Tinkerforge/tng-di8/hardware/di8.kicad_pcb

## KiCad design hardware/di8.kicad_pcb (2020-09-10)

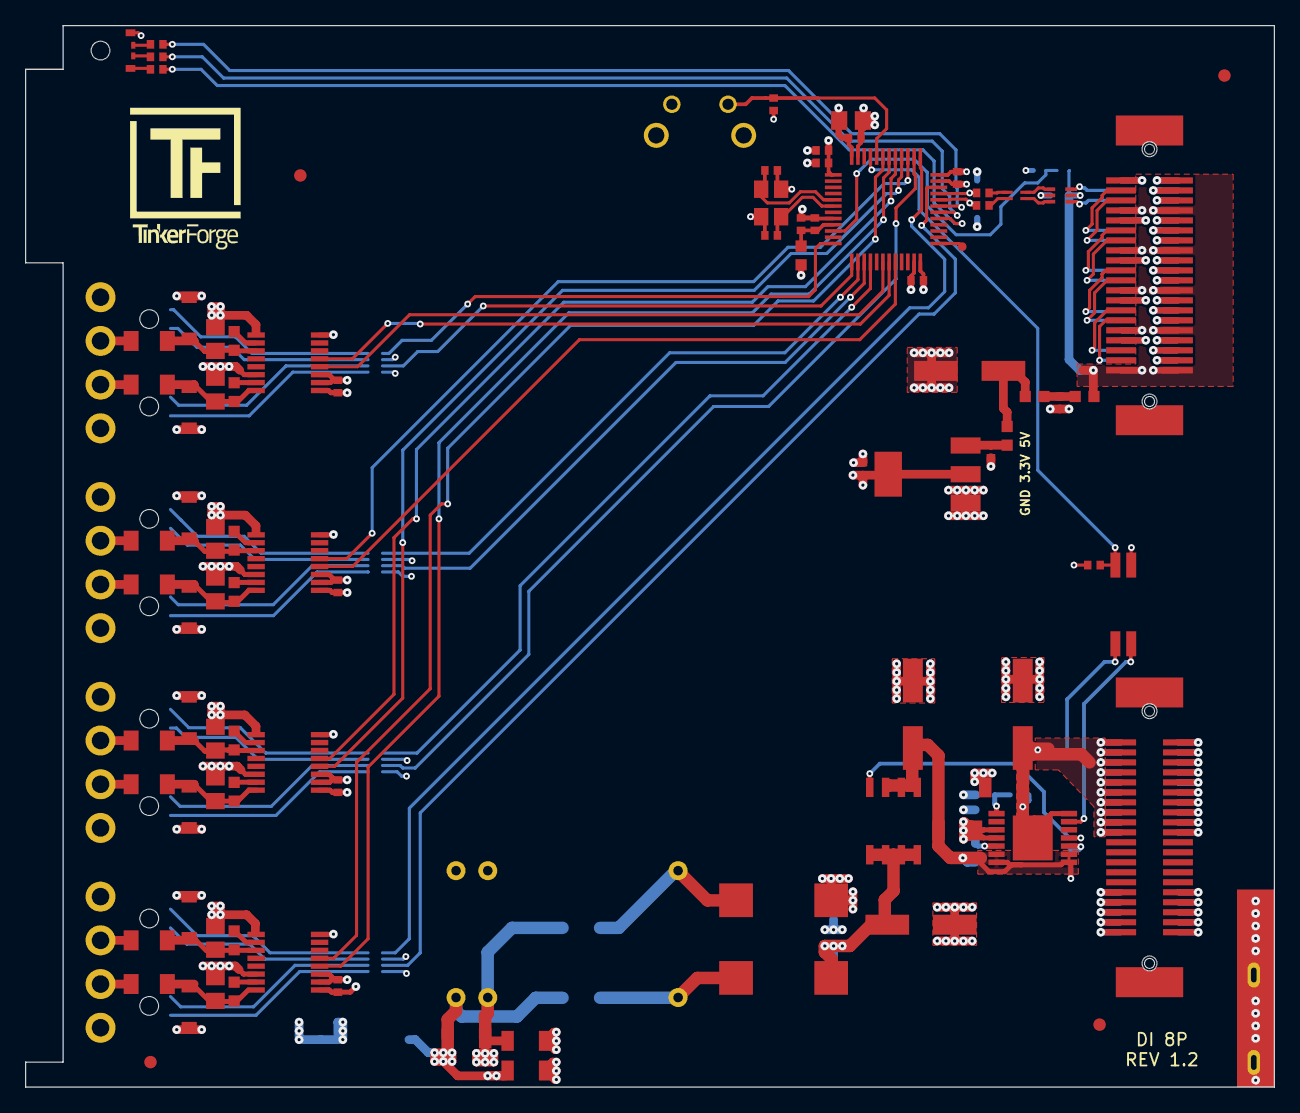
[picture p1: board di8.kicad_pcb from above]

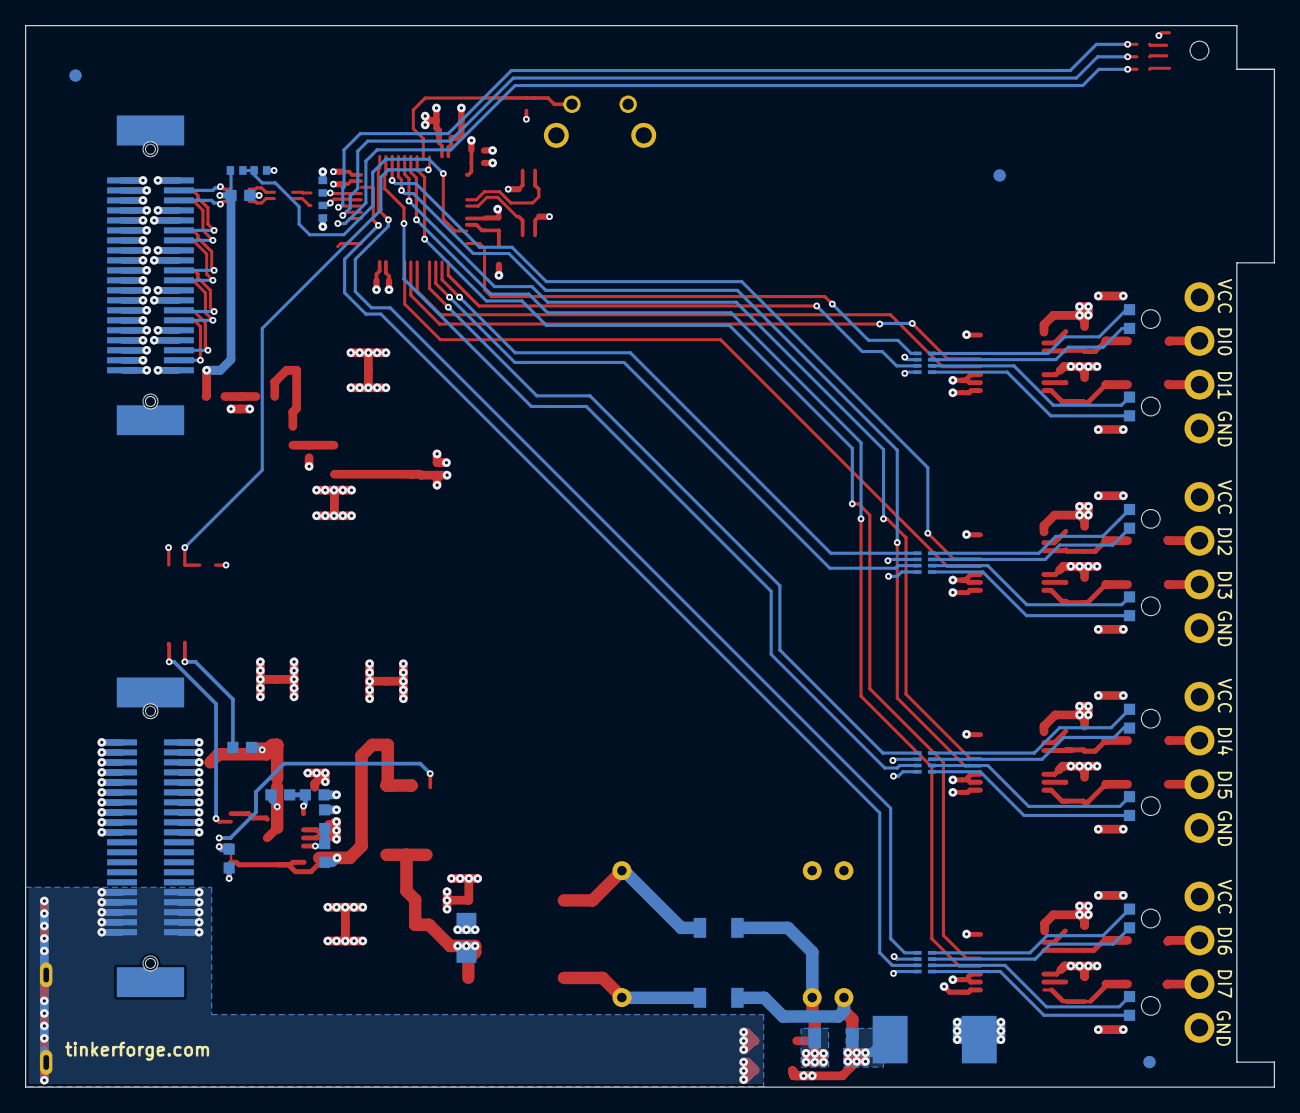
[picture p2: board di8.kicad_pcb from below]

Board: 4 copper layers, 100.0 x 85.0 mm, 130 parts (33 on the bottom side), 106 nets.

Parts:
C101, C102, C116, C117: 1uF; C0402F
C103, C104, C105, C106, C107, C112, C204, C211, C212, C213: 100nF; C0402F
C108, C109: 33pF; C0402F
C110: 10uF; C0805E
C111: 100uF; ELKO_63
C113, C114: 47pF; C0402F
C115: 2.2uF; C0603F
C118: 10uF/50V; C1206
C119, C120: 0; C1206
C121, C125, C126: 10uF/35V; C1206
C122, C123, C124: 100uF/35V; ELKO_63
C127, C128: 1nF/2kV; C1206
C202, C203, C205, C206, C207, C208, C209, C210: DNP; C0805E
D101: 3.0SMI30CATR; SMC
D201, D202, D211, D212, D213, D214, D215, D216: SMF36CA; SOD-123FL
D203, D204, D205, D206, D207, D208, D209, D210: LED; LED-LP
Fiducial_Mark: VAL**; Fiducial_Mark
Fiducial_Mark#2, Fiducial_Mark#3, Fiducial_Mark#4, Fiducial_Mark#5, Fiducial_Mark#6, Fiducial_Mark#7: VAL**; Fiducial_Mark
J101: TNG-Power-TOP; TNG-40-TOP
J102: TNG-Power-BTM; TNG-40-BTM
J103: TNG-Data-TOP; TNG-40-TOP
J104: TNG-Data-BTM; TNG-40-BTM
L101: FB; R0603F
L102, L103, L104: INDUCTs; R0603F
L105: 744230900; WE-CNSW-0603
LED101: EASV3015RGBA0; LED-RGB-LP
P102: Debug; DEBUG_PAD
P103: PE; PE_Hook
P201: INPUT0; OQ_4P
P202: INPUT1; OQ_4P
P203: INPUT2; OQ_4P
P204: INPUT3; OQ_4P
Q101: FDS8449; SOIC-8-MOSFET
R101, R107, R108: 1k; R0402F
R102, R105: 0; R0402F
R103, R104: 22; R0402F
R106: 56; R0402F
R109: 10k; R0402F
R110, R115: 10k; R0603F
R111, R112: DNP; R0603F
R113: 22; R0603F
R114: 68k; R0603F
R116: VC1206K201R030; R1206
R201, R202, R205, R206, R207, R208, R209, R210: 1k; RMELF
R203, R204, R211, R212, R213, R214, R215, R216: 562; R0603F
RP201, RP202, RP203, RP204: 470; 4X0402
SW101: BOOT; TACT-6MM-HOR
T101: 744273222; WE-SL5
U101: STM32F070CBT6; LQFP48
U102: AZ1117EH; SOT-223
U103: 82400152; SOT563-SPEC
U104: DNP; TEL10
U105: TLP293; SOP4
U106: STEF01; HTSSOP14
U201, U202, U203, U204: ISO1212; SSOP16
X101: 8MHz; CRYSTAL_3225

Connections:
3V3: C101.1, C103.1, C104.1, C105.1, C106.1, C110.1, C116.1, C204.2, C211.2, C212.2, C213.2, L101.1, LED101.1, R109.2, RP201.2, RP201.4, RP202.2, RP202.4, RP203.2, RP203.4, RP204.2, RP204.4, SW101.1, U101.1, U101.24, U101.36, U101.48, U102.2, U201.2, U201.3, U202.2, U202.3, U203.2, U203.3, U204.2, U204.3
5VA: C115.1, J103.7, J103.8, J103.15, J103.16, J103.23, J103.24, J103.31, J103.32, J103.39, J103.40, J104.7, J104.8, J104.15, J104.16, J104.23, J104.24, J104.31, J104.32, J104.39, J104.40, L104.1, R107.1, U103.5
+5V: C111.1, L102.1, L103.2
AGND: C118.2, C120.1, C128.2, C202.1, C203.1, C205.1, C206.1, C207.1, C208.1, C209.1, C210.1, D101.2, D201.2, D202.2, D211.2, D212.2, D213.2, D214.2, D215.2, D216.2, P201.4, P202.4, P203.4, P204.4, R116.2, U104.10, U201.9, U201.14, U202.9, U202.14, U203.9, U203.14, U204.9, U204.14
AGNDA: C121.2, C122.2, C123.2, C124.2, C125.2, C126.2, J101.2, J101.4, J101.6, J101.8, J101.10, J101.12, J101.14, J101.16, J101.18, J101.20, J102.1, J102.3, J102.5, J102.7, J102.9, J102.11, J102.13, J102.15, J102.17, J102.19, R112.2, R115.2, T101.2, U106.3, U106.4
AIN0: R107.2, R108.1, U101.10
Earth: C127.2, C128.1, J101.31, J101.32, J101.33, J101.34, J101.35, J101.36, J101.37, J101.38, J101.39, J101.40, J102.31, J102.32, J102.33, J102.34, J102.35, J102.36, J102.37, J102.38, J102.39, J102.40, P103.1
GND: C101.2, C102.2, C103.2, C104.2, C105.2, C106.2, C107.2, C108.1, C109.1, C110.2, C111.2, C112.2, C113.2, C114.2, C115.2, C116.2, C117.2, C204.1, C211.1, C212.1, C213.1, J103.1, J103.2, J103.4, J103.6, J103.9, J103.10, J103.12, J103.14, J103.17, J103.18, J103.20, J103.22, J103.25, J103.26, J103.28, J103.30, J103.33, J103.34, J103.36, J103.38, J104.1, J104.2, J104.3, J104.5, J104.9, J104.10, J104.11, J104.13, J104.17, J104.18, J104.19, J104.21, J104.25, J104.26, J104.27, J104.29, J104.33, J104.34, J104.35, J104.37, R101.1, R108.2, U101.8, U101.23, U101.35, U101.47, U102.1, U103.2, U105.3, U201.1, U201.8, U202.1, U202.8, U203.1, U203.8, U204.1, U204.8, X101.3
IN0: U101.18, U201.4
IN1: U101.19, U201.5
IN2: U101.20, U202.4
IN3: U101.39, U202.5
IN4: U101.40, U203.4
IN5: U101.41, U203.5
IN6: U101.42, U204.4
IN7: U101.43, U204.5
LED0: RP201.1, U101.12
LED1: RP201.3, U101.13
LED2: RP202.1, U101.14
LED3: RP202.3, U101.15
LED4: RP203.1, U101.16
LED5: RP203.3, U101.38
LED6: RP204.1, U101.37
LED7: RP204.3, U101.34
LEDB: R106.1, U101.31
LEDG: R105.1, U101.30
LEDR: R102.1, U101.29
unnamed: C102.1, C107.1, L101.2, U101.9
unnamed: C108.2, U101.5, X101.2
unnamed: C109.2, U101.6, X101.1
unnamed: C112.1, L103.1, L104.2
unnamed: C117.1, L102.2, U102.3
unnamed: C119.2, T101.4, U104.16
unnamed: C120.2, T101.3, U104.1
unnamed: C121.1, C123.1, Q101.D, T101.1
unnamed: C202.2, D202.1, R201.1, R203.2, U201.16
unnamed: C203.2, D201.1, R202.1, R204.2, U201.11
unnamed: C205.2, D214.1, R205.1, R211.2, U202.16
unnamed: C206.2, D211.1, R206.1, R212.2, U202.11
unnamed: C207.2, D215.1, R207.1, R213.2, U203.16
unnamed: C208.2, D212.1, R208.1, R214.2, U203.11
unnamed: C209.2, D216.1, R209.1, R215.2, U204.16
unnamed: C210.2, D213.1, R210.1, R216.2, U204.11
unnamed: D203.1, RP201.7
unnamed: D203.2, RP201.8
unnamed: D204.1, RP201.5
unnamed: D204.2, RP201.6
unnamed: D205.1, RP202.7
unnamed: D205.2, RP202.8
unnamed: D206.1, RP202.5
unnamed: D206.2, RP202.6
unnamed: D207.1, RP203.7
unnamed: D207.2, RP203.8
unnamed: D208.1, RP203.5
unnamed: D208.2, RP203.6
unnamed: D209.1, RP204.7
unnamed: D209.2, RP204.8
unnamed: D210.1, RP204.5
unnamed: D210.2, RP204.6
unnamed: J103.3, J104.12
unnamed: J103.5, J104.14
unnamed: J103.11, J104.20
unnamed: J103.13, J104.22
unnamed: J103.19, J104.28
unnamed: J103.21, J104.30
unnamed: J103.27, J104.36
unnamed: J103.29, J104.38
unnamed: LED101.2, R106.2
unnamed: LED101.3, R105.2
unnamed: LED101.4, R102.2
unnamed: P102.1, U101.25
unnamed: P201.2, R202.2
unnamed: P201.3, R201.2
unnamed: P202.2, R206.2
unnamed: P202.3, R205.2
unnamed: P203.2, R208.2
unnamed: P203.3, R207.2
unnamed: P204.2, R210.2
unnamed: P204.3, R209.2
unnamed: Q101.G, U106.11
unnamed: R101.2, SW101.2, U101.44
unnamed: R110.2, U105.1
unnamed: R111.2, R112.1, U106.5
unnamed: R113.2, U106.10
unnamed: R114.2, R115.1, U106.1
unnamed: R203.1, U201.15
unnamed: R204.1, U201.10
unnamed: R211.1, U202.15
unnamed: R212.1, U202.10
unnamed: R213.1, U203.15
unnamed: R214.1, U203.10
unnamed: R215.1, U204.15
unnamed: R216.1, U204.10
PWR_GOOD: R109.1, U101.45, U105.4
PWR_PG: U105.2, U106.13
USB-DM: C114.1, R104.2, U101.32
USB-DMA: J104.6, U103.4
USB-DMB: L105.1, U103.3
USB-DMC: L105.2, R104.1
USB-DP: C113.1, R103.2, U101.33
USB-DPA: J104.4, U103.6
USB-DPB: L105.4, U103.1
USB-DPC: L105.3, R103.1
VCC: C118.1, C119.1, C127.1, D101.1, P201.1, P202.1, P203.1, P204.1, R116.1, U104.9
VCCPWRA: C122.1, C126.1, J101.1, J101.3, J101.5, J101.7, J101.9, J101.11, J101.13, J101.15, J101.17, J101.19, J102.2, J102.4, J102.6, J102.8, J102.10, J102.12, J102.14, J102.16, J102.18, J102.20, R110.1, R114.1, U106.14, U106.EXP
VO: C124.1, C125.1, Q101.S, R111.1, R113.1, U106.6, U106.7, U106.8, U106.9
