Tinkerforge/tng-di8/(commit log)

2019-06-07 Move system timer initialization to bricklib
2019-06-19 start hardware design, schematic nearly finished
    [di8.kicad_pcb, di8.sch, inputs.sch]
2019-07-01 add first parts to pcb
    [di8.kicad_pcb]
2019-07-09 partial placement
    [di8.kicad_pcb, inputs.sch]
2019-07-24 add dc dc converter, routing
    [di8.kicad_pcb, di8.sch, inputs.sch]
2019-07-24 more routing
    [di8.kicad_pcb, di8.sch]
2019-07-25 routing completed
    [di8.kicad_pcb, di8.sch, inputs.sch]
2019-07-25 routing improvement, ordered version 1.0
    [di8.kicad_pcb]
2019-08-20 Change processor to STM32F070xB
2019-08-20 Implement test di8 driver
2019-08-26 add hints
    [di8.kicad_pcb]
2019-08-26 add another hint
    [di8.kicad_pcb]
2019-10-02 add input protection (not finished)
    [di8.sch, inputs.sch]
2019-10-16 version 1.1 fully routed
    [di8.kicad_pcb, di8.sch]
2019-10-18 specify tvs diodes, add fiducials
    [di8.kicad_pcb, inputs.sch]
2019-11-08 cutout for rgb led added
    [di8.kicad_pcb]
2019-11-20 add boot switch
    [di8.kicad_pcb, di8.sch]
2019-11-22 improve lightpipes
    [di8.kicad_pcb]
2019-11-22 add vcc input protection
    [di8.kicad_pcb, di8.sch, inputs.sch]
2019-11-28 outline update
    [di8.kicad_pcb]
2019-12-10 fix name
    [di8.kicad_pcb, di8.sch, inputs.sch]
2019-12-23 update rgb led drill diameter
    [di8.kicad_pcb]
2019-12-30 fix inductor footprints
    [di8.kicad_pcb, di8.sch]
2020-03-02 add hook footprint
    [di8.kicad_pcb]
2020-05-14 fix values
    [di8.kicad_pcb, di8.sch]
2020-05-14 fix value
    [di8.kicad_pcb, di8.sch]
2020-07-27 Add TIM defines for status LEDs
2020-09-04 add version 1.2
    fix footprints
    [di8.kicad_pcb, di8.sch, inputs.sch]
2020-09-07 specify capactors
    [di8.kicad_pcb, di8.sch]
2020-09-07 fix stuff
    [di8.kicad_pcb, di8.sch, inputs.sch]
2020-09-08 all footprints updated
    [di8.kicad_pcb]
2020-09-09 default is non implemented
    [di8.kicad_pcb, di8.sch]
2020-09-10 fix 3d stuff
    [di8.kicad_pcb]
