Tinkerforge/tng-di8/(notices)

Notices in the files:
hardware/inputs.sch:
Licensed under CERN OHL v.1.1
Copyright (©) 2020, B.Nordmeyer
hardware/di8.kicad_pcb:
Copyright Tinkerforge GmbH 2020.
This documentation describes Open Hardware and is licensed under the
CERN OHL v. 1.1.
